Destination-SPACE/Weather-Station-r3-Hardware/README.md

# Weather-Station-r3
Destination Weather Station R3 Hardware

# License
Licensed under the CERN OHLv2 - [Permissive](https://github.com/Destination-SPACE/Weather-Station-r3-Hardware/blob/main/LICENSE) or as referenced
