Destination-SPACE/Weather-Station-r3-Hardware/CAD-files/sch_rev2.pdf

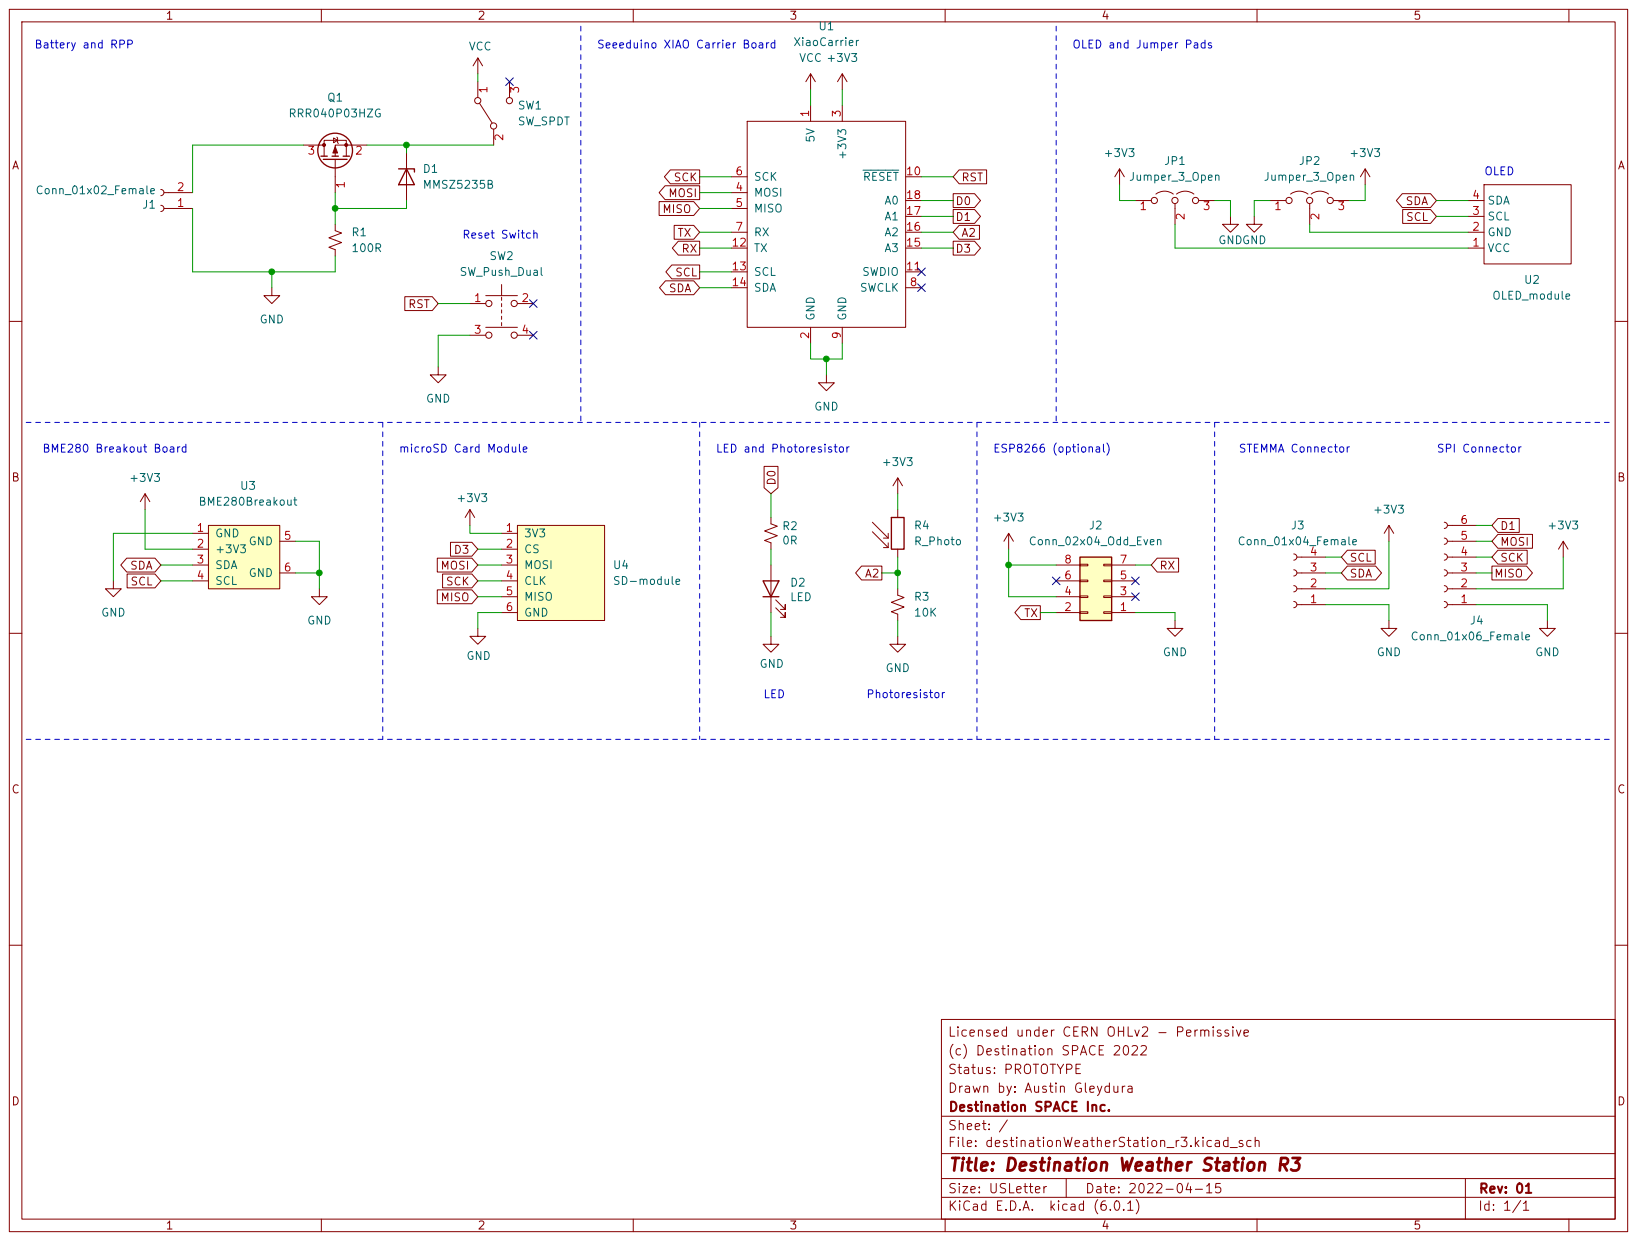
[picture p1: page 1]
