Destination-SPACE/Weather-Station-r3-Hardware/CAD-files/destinationWeatherStation_r3.kicad_pcb

## KiCad design CAD-files/destinationWeatherStation_r3.kicad_pcb (2022-08-17)

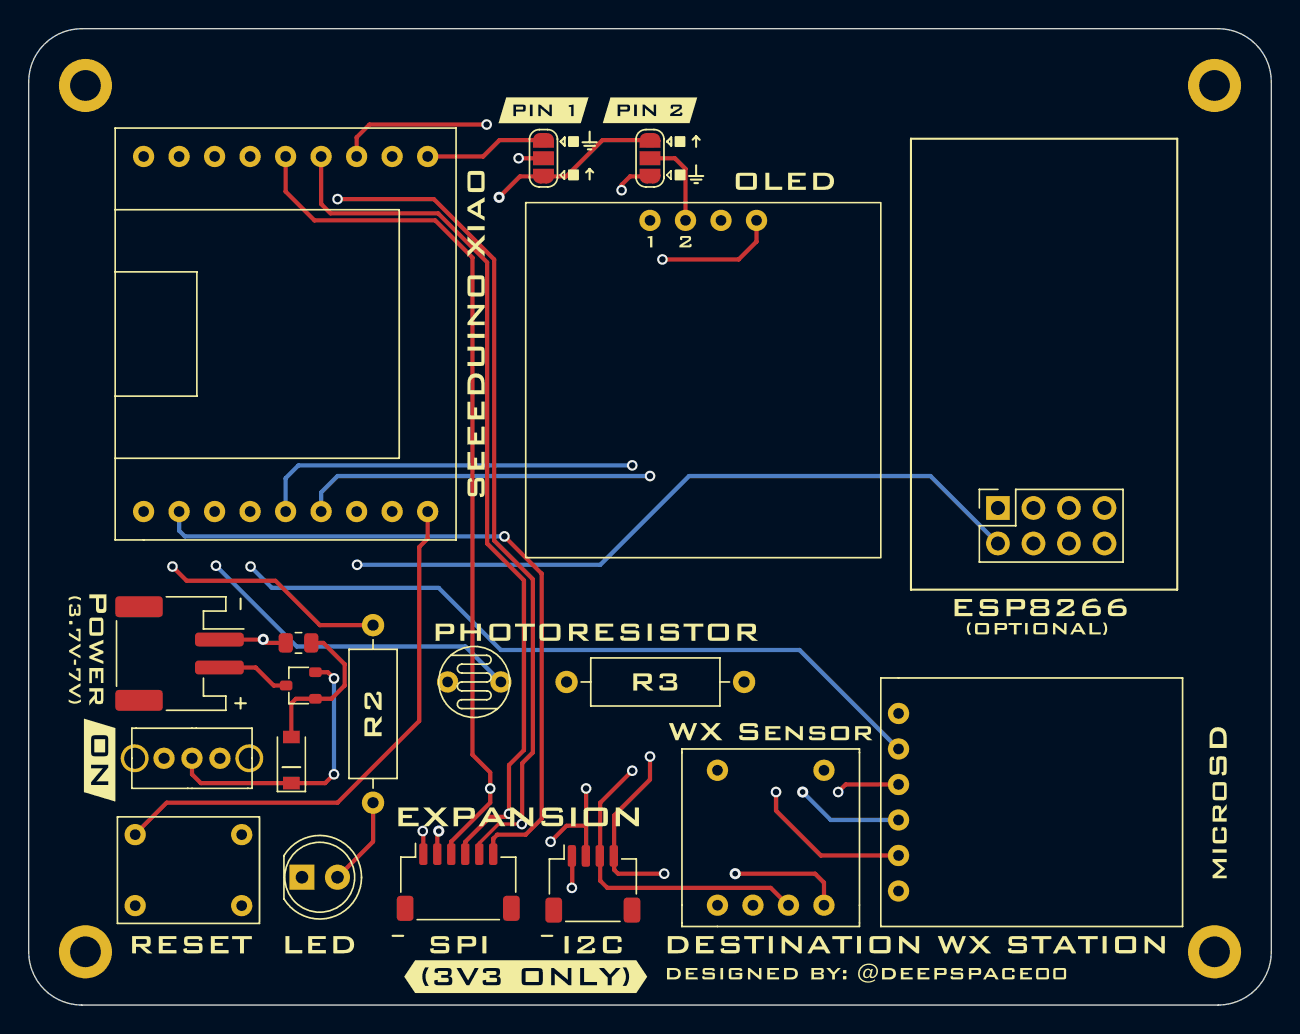
[picture p2: board destinationWeatherStation_r3.kicad_pcb from above]

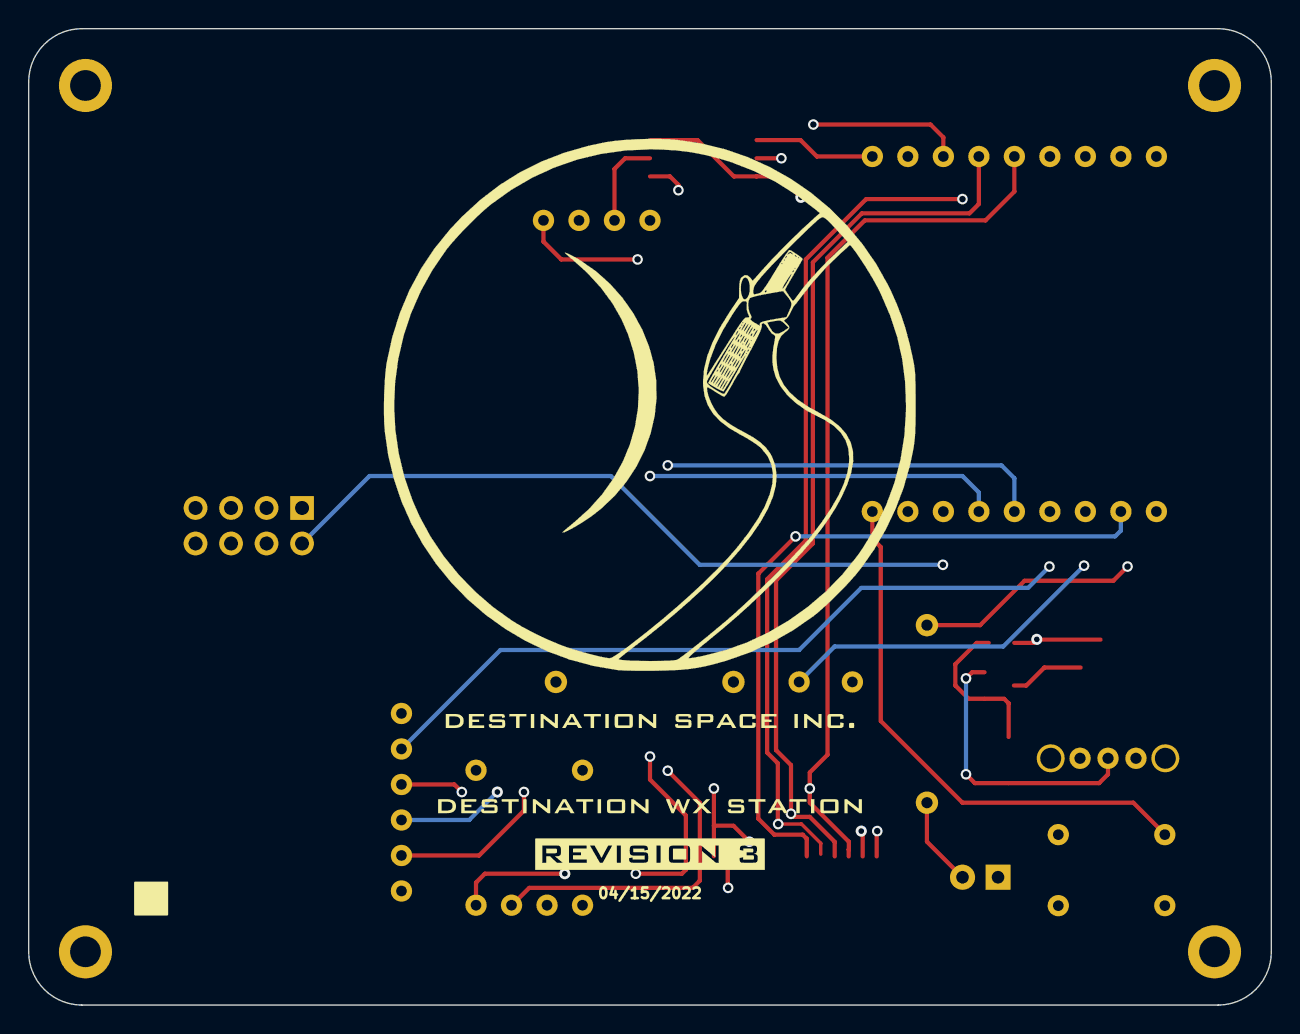
[picture p3: board destinationWeatherStation_r3.kicad_pcb from below]

Board: 4 copper layers, 88.9 x 69.8 mm, 46 parts (3 on the bottom side), 21 nets.

Parts:
D1: MMSZ5235B; D_SOD-123
D2: LED; LED_D5.0mm
J1: Conn_01x02_Female; JST_PH_S2B-PH-SM4-TB_1x02-1MP_P2.00mm_Horizontal
J2: Conn_02x04_Odd_Even; PinHeader_2x04_P2.54mm_Vertical
J3: Conn_01x04_Female; JST_SH_SM04B-SRSS-TB_1x04-1MP_P1.00mm_Horizontal
J4: Conn_01x06_Female; JST_SH_SM06B-SRSS-TB_1x06-1MP_P1.00mm_Horizontal
JP1, JP2: Jumper_3_Open; SolderJumper-3_P1.3mm_Open_RoundedPad1.0x1.5mm
Q1: RRR040P03HZG; SC-96
R1: 100R; R_0805_2012Metric
R2: R_Small_US; R_Axial_DIN0309_L9.0mm_D3.2mm_P12.70mm_Horizontal
R3: 10K; R_Axial_DIN0309_L9.0mm_D3.2mm_P12.70mm_Horizontal
R4: R_Photo; photoresistor
SW1: SW_SPDT
SW2: SW_Push_Dual; DPDTPushButton
U1: XiaoCarrier
U2: OLED_module
U3: BME280Breakout
U4: SD-module; SDModule
kibuzzard-6212B2ED: G***; kibuzzard-6212B2ED
kibuzzard-62111A8A: G***; kibuzzard-62111A8A
kibuzzard-62111A14: G***; kibuzzard-62111A14
kibuzzard-62111A45: G***; kibuzzard-62111A45
kibuzzard-62111ABC: G***; kibuzzard-62111ABC
kibuzzard-62111B43: G***; kibuzzard-62111B43
kibuzzard-62155D2C: G***; kibuzzard-62155D2C
kibuzzard-62598C40: G***; kibuzzard-62598C40
kibuzzard-621113A9: G***; kibuzzard-621113A9
kibuzzard-621113E9: G***; kibuzzard-621113E9
kibuzzard-621114C2: G***; kibuzzard-621114C2
kibuzzard-6211110C: G***; kibuzzard-6211110C
kibuzzard-6211115D: G***; kibuzzard-6211115D
kibuzzard-6211129D: G***; kibuzzard-6211129D
kibuzzard-6211136D: G***; kibuzzard-6211136D
kibuzzard-6211140D: G***; kibuzzard-6211140D
kibuzzard-6211193D: G***; kibuzzard-6211193D
kibuzzard-62111182: G***; kibuzzard-62111182
kibuzzard-62111204: G***; kibuzzard-62111204
kibuzzard-62111233: G***; kibuzzard-62111233
kibuzzard-62111258: G***; kibuzzard-62111258
kibuzzard-62111327: G***; kibuzzard-62111327
kibuzzard-62111432: G***; kibuzzard-62111432
kibuzzard-62111477: G***; kibuzzard-62111477
kibuzzard-62111924: G***; kibuzzard-62111924
kibuzzard-62111949: G***; kibuzzard-62111949
kibuzzard-62360720: G***; kibuzzard-62360720

Connections:
+3V3: J2.4, J2.8, J3.2, J4.2, JP1.1 (A), JP2.3 (B), R4.1, U1.3 (+3V3), U3.2 (+3V3), U4.1 (3V3)
A2: R3.1, R4.2, U1.16 (A2)
D0: R2.1, U1.18 (A0)
D1: J4.6, U1.17 (A1)
D3: U1.15 (A3), U4.2 (CS)
GND: D2.1 (K), J1.1, J2.1, J3.1, J4.1, JP1.3 (B), JP2.1 (A), R1.2, R3.2, SW2.3, U1.2 (GND), U1.9 (GND), U3.1 (GND), U3.5 (GND), U3.6 (GND), U4.6 (GND)
MISO: J4.3, U1.5 (MISO), U4.5 (MISO)
MOSI: J4.5, U1.4 (MOSI), U4.3 (MOSI)
unnamed: D1.1 (K), Q1.2 (S), SW1.2 (B)
unnamed: D1.2 (A), Q1.1 (G), R1.1
unnamed: D2.2 (A), R2.2
unnamed: J1.2, Q1.3 (D)
unnamed: JP1.2 (C), U2.1 (VCC)
unnamed: JP2.2 (C), U2.2 (GND)
RST: SW2.1, U1.10 (~RESET)
RX: J2.7, U1.7 (RX)
SCK: J4.4, U1.6 (SCK), U4.4 (CLK)
SCL: J3.4, U1.13 (SCL), U2.3 (SCL), U3.4 (SCL)
SDA: J3.3, U1.14 (SDA), U2.4 (SDA), U3.3 (SDA)
TX: J2.2, U1.12 (TX)
VCC: SW1.1 (A), U1.1 (5V)
