Destination-SPACE/Weather-Station-r3-Hardware/documents/03_12_22_AssemblyInstructions_printable.pdf

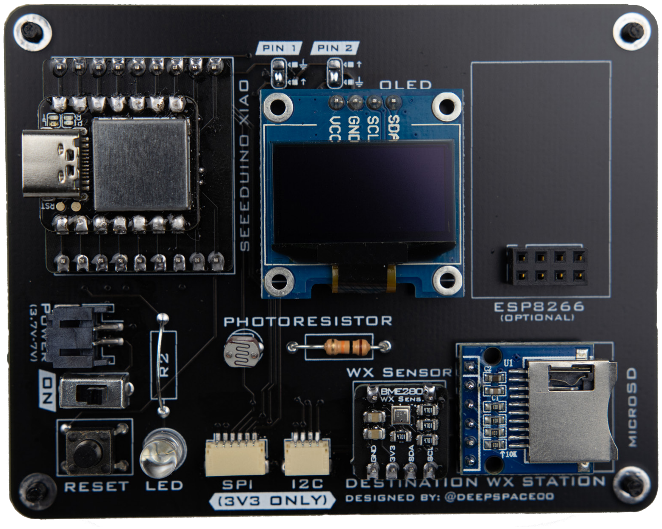
[picture p13: figure]
