Destination-SPACE/Weather-Station-r3-Hardware/documents/03_12_22_AssemblyInstructions_printable.pdf

## Destination Weather Station Assembly Instructions

Edited: 03/12/2022
By: Austin Gleydura

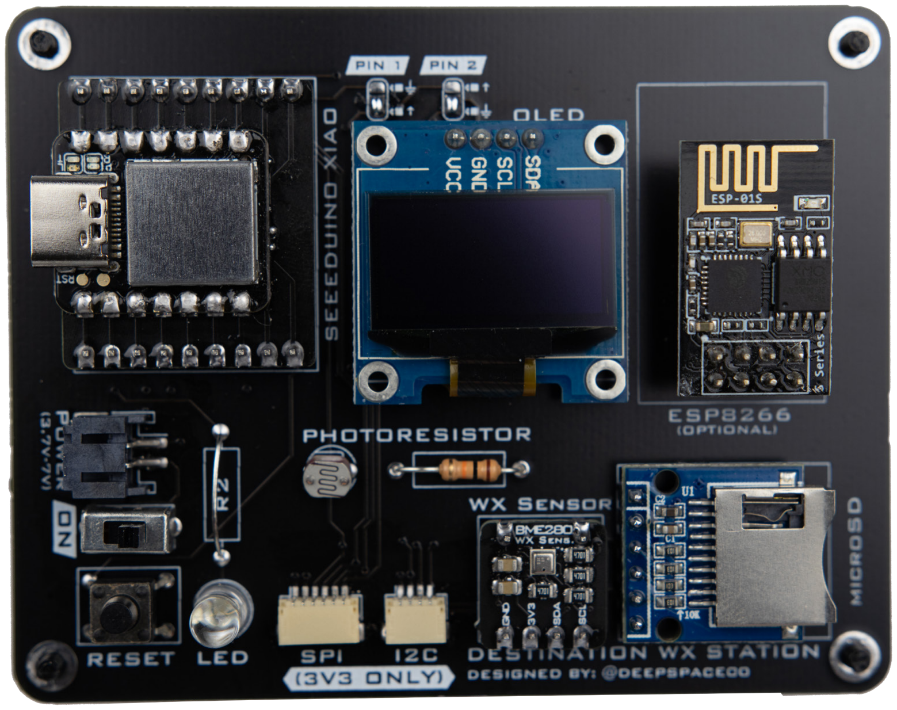
[picture p9: figure]

## Components

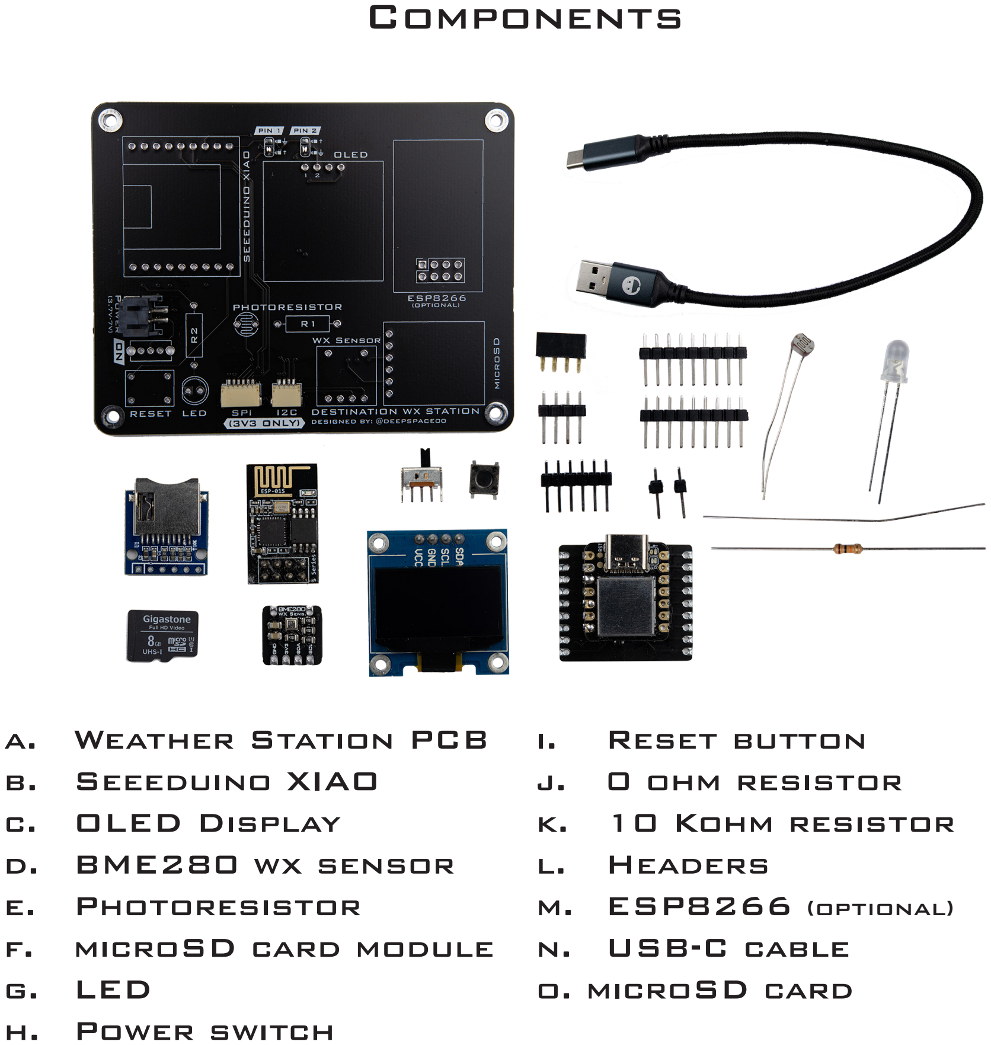
[picture p10: page 2]

a. Weather Station PCB
b. Seeeduino XIAO
c. OLED Display
d. BME280 wx sensor
e. Photoresistor
f. microSD card module
g. LED
h. Power switch
i. Reset button
j. 0 ohm resistor
k. 10 Kohm resistor
l. Headers
m. ESP8266 (optional)
n. USB-C cable
o. microSD card

A.

C. B.

D.

E.

F.

G.

H. I.

J.

K.

L.

M.

N.

O.

## Assembly

- Place the long side of the 1x9 headers into the PCB as shown below
- Solder the headers onto the PCB

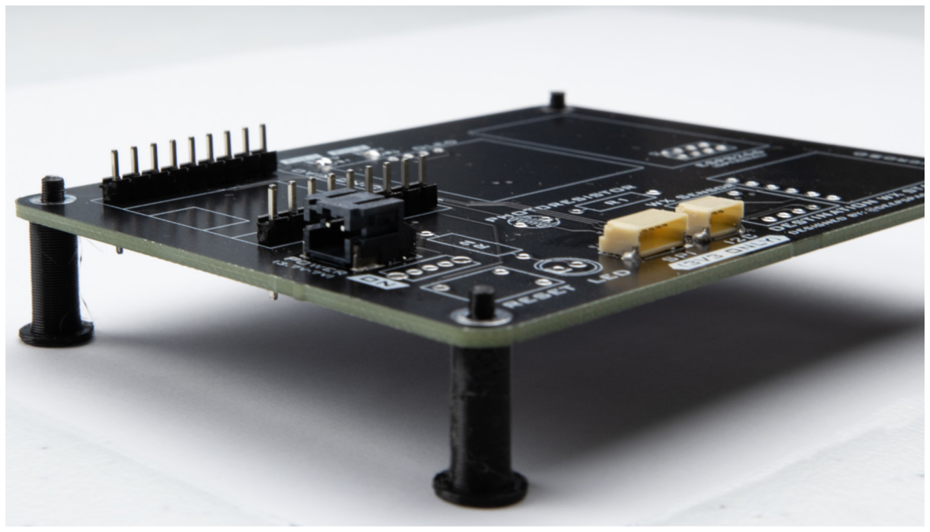
[picture p11: figure]

- Similarly, solder the 1x4, 1x1, and 1x6 headers to the PCB for the WX sensor, and microSD module
- Solder the 2x4 header on for the ESP8266 module
- Solder the XIAO, OLED, WX sensor, and microSD module to the headers

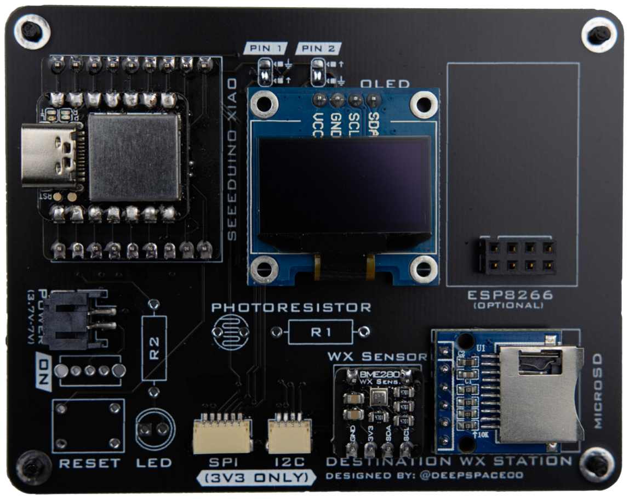
[picture p12: figure]

- Solder the 10K resistor in R1
- Solder the 0 ohm resistor in R2
- Solder the photoresistor to the PCB
- Making sure the flat side of the LED is lined up with the markings on the PCB, solder the LED
- Solder the power switch and the button to the PCB
- Cut ends of the leads for the resistors and the LEDs off.

## Your PCB should look like this
