Destination-SPACE/Weather-Station-r3-Hardware/(notices)

Notices in the files:
CAD-files/destinationWeatherStation_r3.kicad_sch:
Licensed under CERN OHLv2 - Permissive
